detoledovictor/eSYS24-master/hardware/Transceiver/README.MD

# Overview
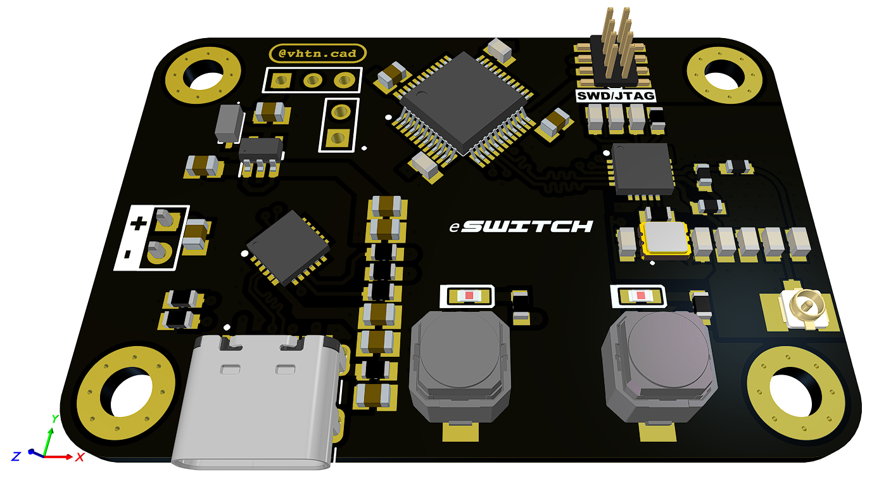
[picture p3: Images/eswitch_3D.PNG]
PCB 3D View


eSWITCH24 hardware designed with a four layers FR4 PCB material. I need four layer to implement the RF Stackup and better power plains that gives me flexibility to control power consumption in various scenarios.

I placed RF paths on the top layer with impedance control for Sub-GHz and 2.4 GHz frequencies.

As a handle IoT Switch, it needs to be literally wireless. So for this I design all the system to be powered up by an **ER14505 or ER25600 (AA) Lithium battery.**

For simplify the manufacture, I selected 0603 passive componnents, it's more easy to hand soldering.
To communicate PC USB with the MCU, I used the brigde [CP2102](https://www.silabs.com/documents/public/data-sheets/cp2102n-datasheet.pdf) it's more powerful and trustworthy than the CH341SER (used in the Arduino's board).
To reduce the **power consumption**, used the Low DropOut linear regulator [AP2112](https://www.diodes.com/assets/Datasheets/AP2112.pdf), instead of use a simple Linear Regulator.

This PCB is originally designed with Altium Designer version 21. All the files that required to build the PCB are included in [PCB files](/hardware/Transceiver/PCB_Files).

## Layers
After routing wires for all components I placed polygons on each layer. In table below I show all the polygons and their purpose in our design.

| Layer | Polygons Description |Image  |
| --- | --- |---|
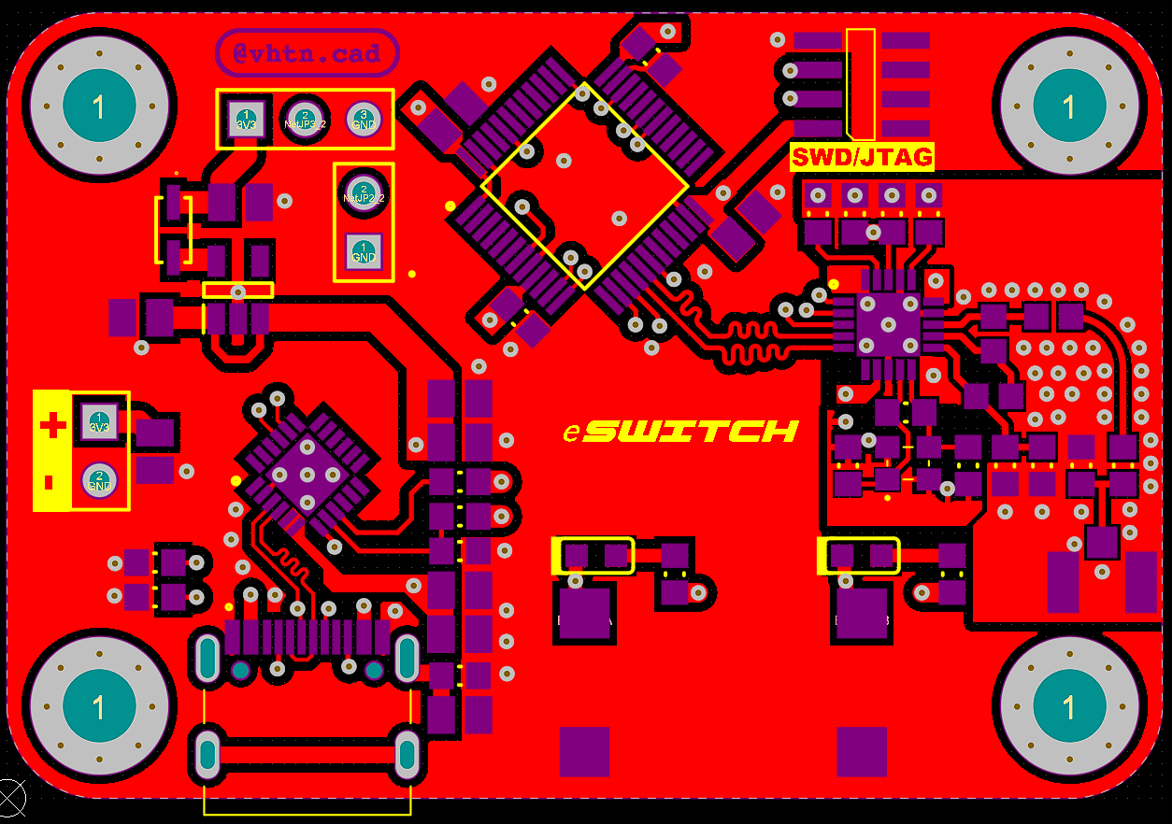
[picture p4: Images/eswitch_top.PNG]
Top Layer Polygon
| Top | Connected to GND.<br /> Multiple Polygons.<br /> Includes impedance control for RF paths.<br /> and all others connections. | |
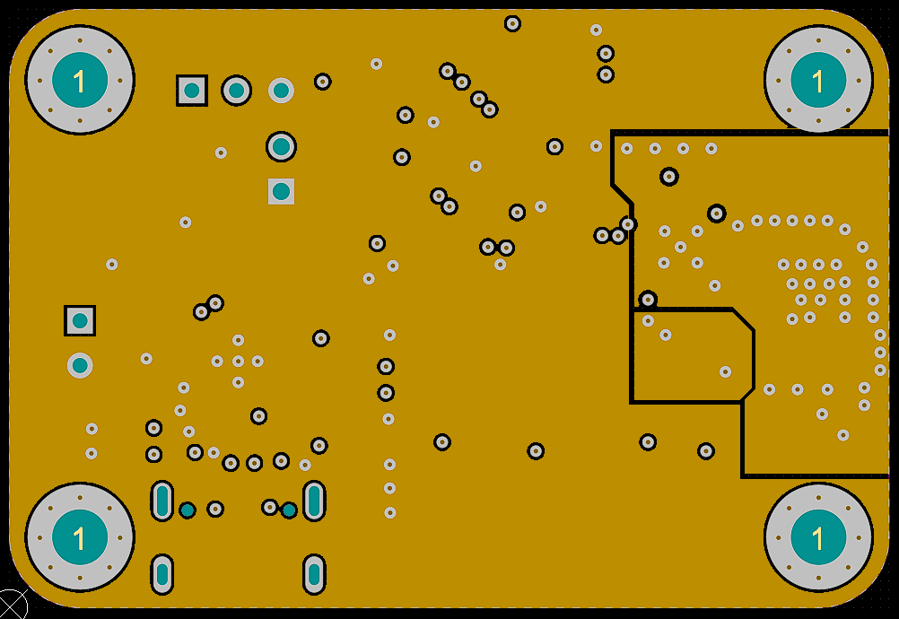
[picture p5: Images/eswitch_mid1.PNG]
Inner Layer 1 Polygon
| Inner 1 | Connected to GND. | |
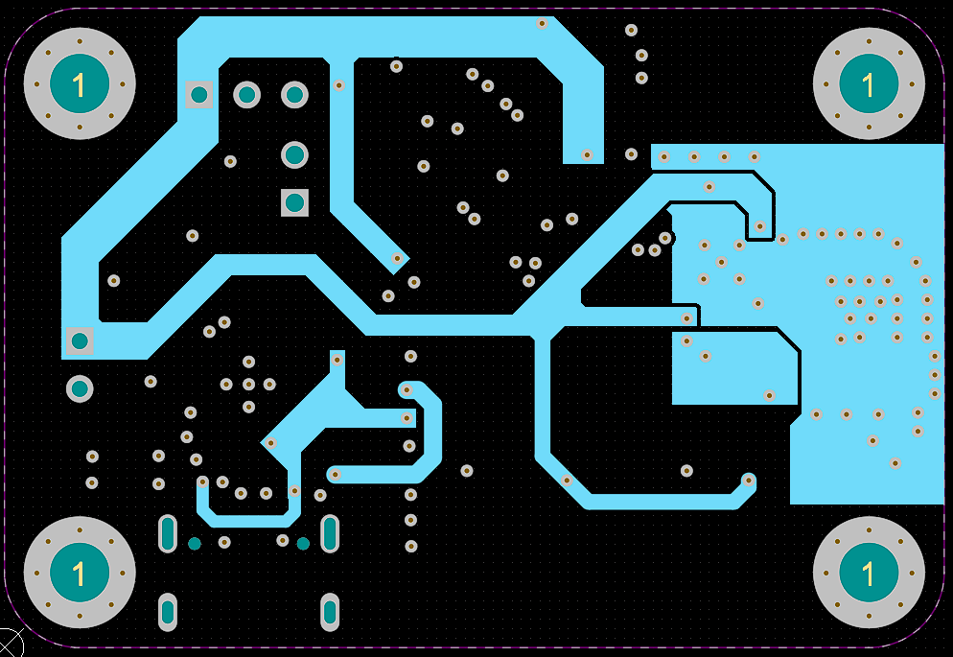
[picture p6: Images/eswitch_mid2.PNG]
Inner Layer 2 Polygon
| Inner 2 | Connected to POWER LINES. | |
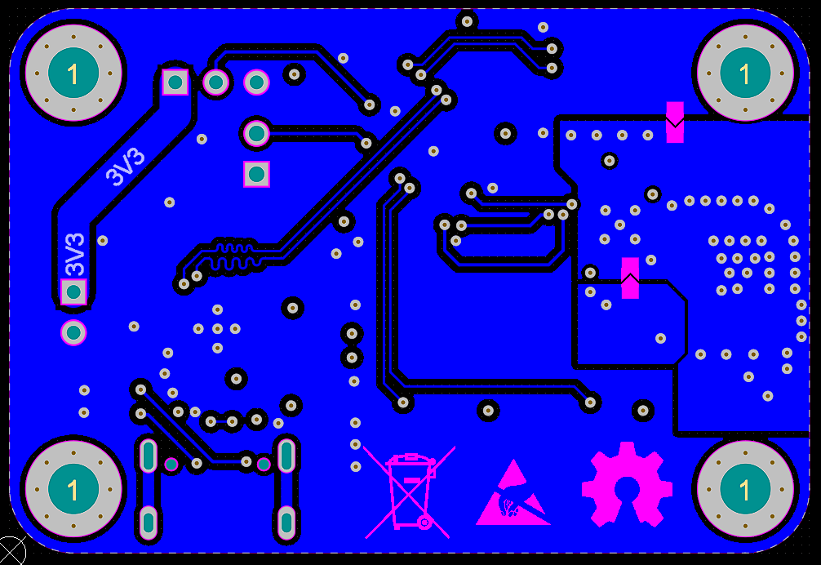
[picture p7: Images/eswitch_bottom.PNG]
Bottom Layer Polygon
| Bottom | Connected to GND.<br /> and to anothoer signal traces| |

## How to Use
To use PCB files in this directory follow these steps:
- Install the latest version of the [Altium Designer](https://www.altium.com/products/downloads)
- Download and extract [PCB files](/hardware/Transceiver/PCB_Files)
- Open project in Altium Designer
