detoledovictor/eSYS24-master/hardware/Receiver/README.MD

# Overview
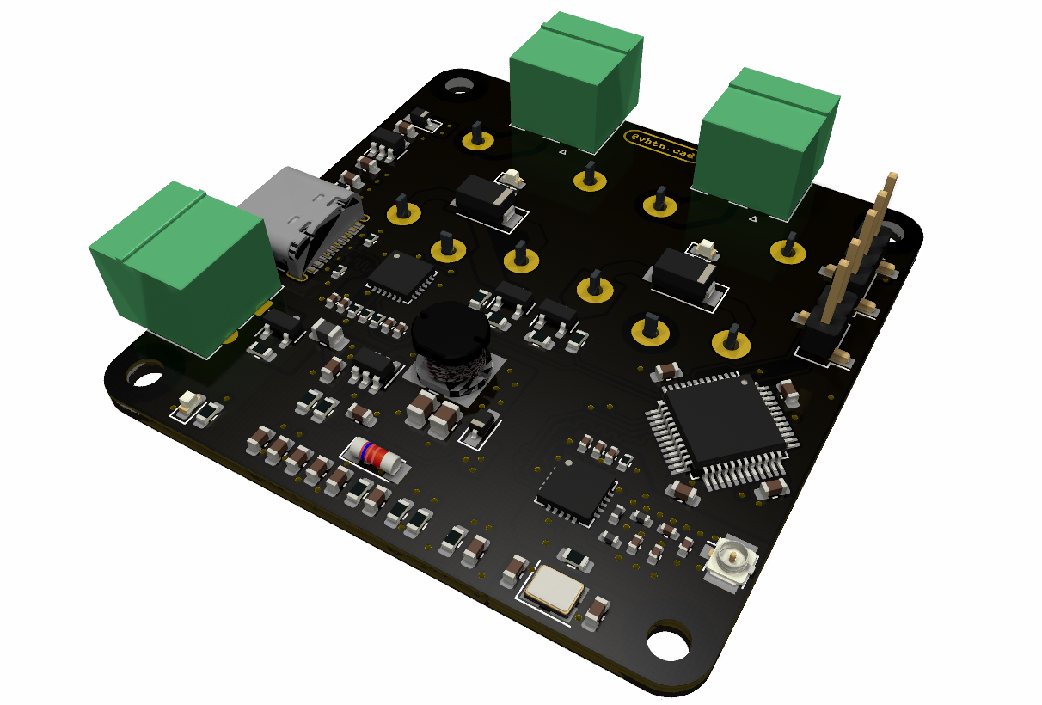
[picture p8: Images/econtrol_3Da.PNG]
PCB 3D View


eCONTROL24 hardware designed with a four layers FR4 PCB material. I need four layer to implement the RF Stackup and better power plains that gives me flexibility to control power consumption in various scenarios.

I placed RF paths on the top layer with impedance control for Sub-GHz and 2.4 GHz frequencies.

For simplify the manufacture, I selected for the great part of passive componnents 0603 package, it's more easy to hand soldering. Otherwise, I had to use 0402 passive componnets to the RF path and for the USB Bridge filter (**ONLY FOR OPTIMIZE SPACE**).<br />

To communicate PC USB with the MCU, I used the brigde [CP2102](https://www.silabs.com/documents/public/data-sheets/cp2102n-datasheet.pdf) it's more powerful and trustworthy than the CH341SER (used in the Arduino's board).<br />

Here we've a DC/DC converter, for this I used the [TPS564201](https://www.ti.com/lit/ds/symlink/tps564201.pdf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)  Synchronous Step-Down Voltage Regulator <br />

As we need an external power supply, the polarity protection is necessary, so the [FDN340P](https://www.onsemi.com/pdf/datasheet/fdn340p-d.pdf) will help us in this part.

To show the data received via RF, an [oLED 0.96inch](https://www.vishay.com/docs/37902/oled128o064dbpp3n00000.pdf) will be soldered in the bottom, how it uses the I2C communication, only 2 pins of the MCU are used to show the data, and why not debug too?!

This PCB is originally designed with KiCAD version 6. All the files that required to build the PCB are included in [PCB files](/hardware/Receiver/PCB_Files).

## Layers
After routing wires for all components I placed polygons on each layer. In table below I show all the polygons and their purpose in our design.

| Layer | Polygons Description |Image  |
| --- | --- |---|
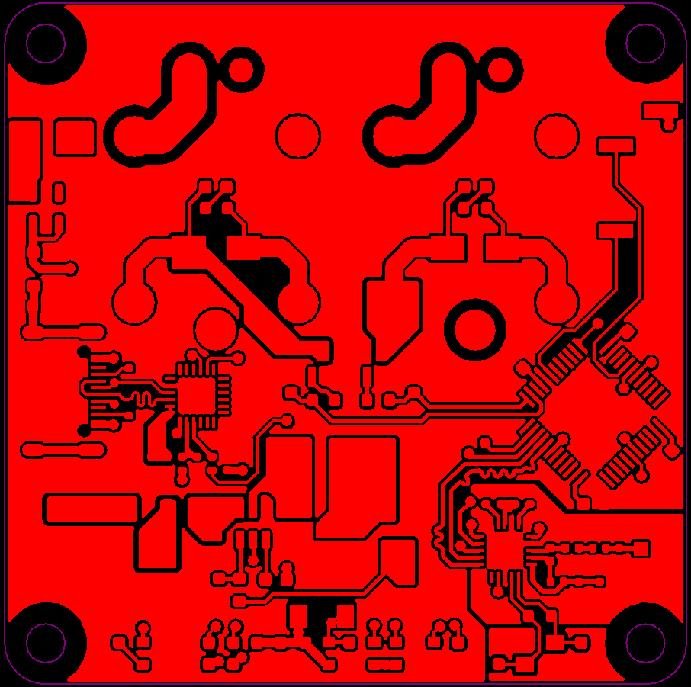
[picture p9: Images/econtrol_top.PNG]
Top Layer Polygon
| Top | Connected to GND.<br /> Multiple Polygons.<br /> Includes impedance control for RF paths.<br />and all others connections. | |
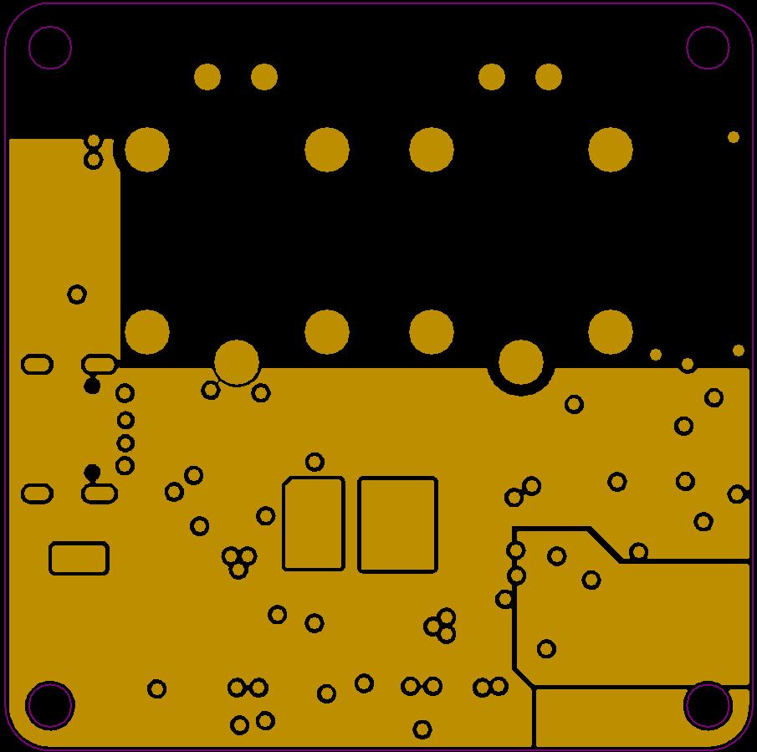
[picture p10: Images/econtrol_mid1.PNG]
Inner Layer 1 Polygon
| Inner 1 | Connected to GND. | |
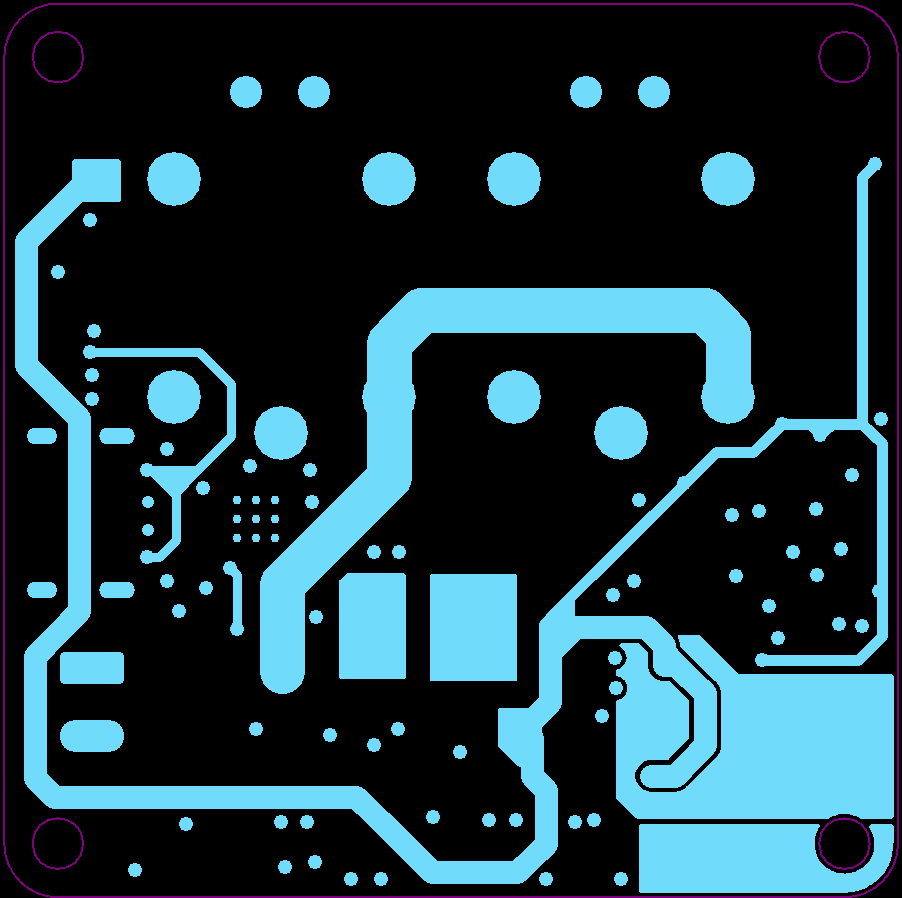
[picture p11: Images/econtrol_mid2.PNG]
Inner Layer 2 Polygon
| Inner 2 | Connected to POWER LINES. | |
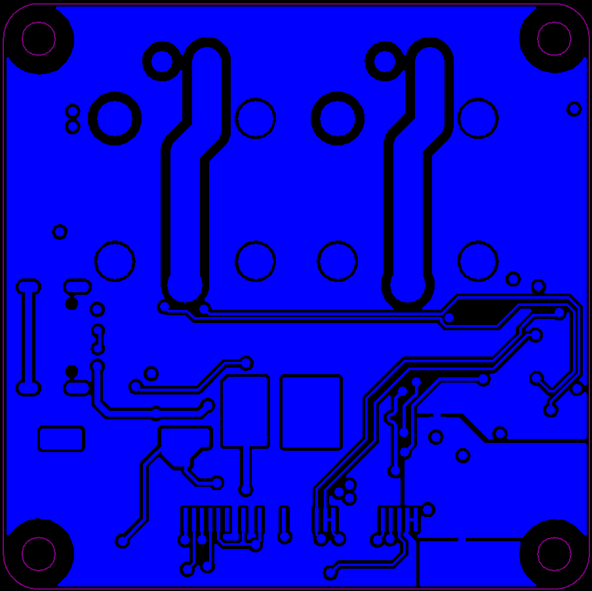
[picture p12: Images/econtrol_bottom.PNG]
Bottom Layer Polygon
| Bottom | Connected to GND.<br />and to anothoer signal traces. | |

## How to Use
To use PCB files in this directory follow these steps:
- Install the latest version of the [KiCAD](https://www.kicad.org/download/)
- Download and extract [PCB files](/hardware/Receiver/PCB_Files)
- Open project in KiCAD
