detoledovictor/eSYS24-master/hardware/Transceiver/PCB_Files/README.MD

## How to Use Altium Sources
To use PCB files in this directory follow these steps:
- Install the latest version of the [Altium Designer](https://www.altium.com/products/downloads)
- Download and extract the [files](./eSWITCH24.zip)
- Open project in Altium Designer
