detoledovictor/eSYS24-master/hardware/Receiver/PCB_Files/README.MD

## How to Use KiCAD Sources
To use PCB files in this directory follow these steps:
- Install the latest version of the [KiCAD](https://www.kicad.org/download/)
- Download and extract the [files](./eCONTROL24.zip)
- Open project in KiCAD
