detoledovictor/eSYS24-master/Images/econtrol3Db.PNG

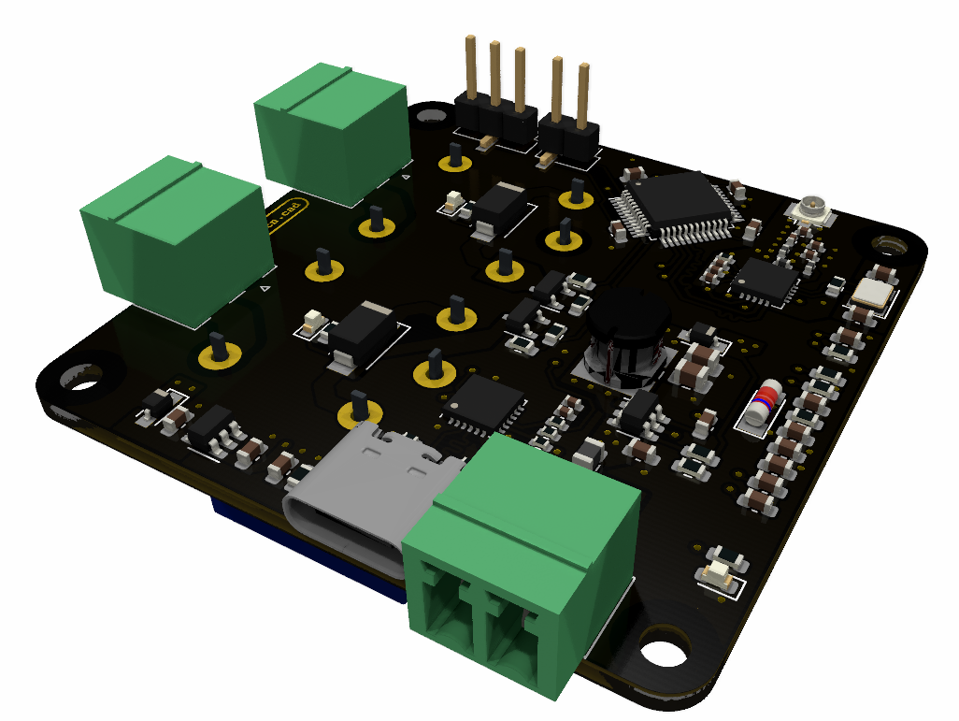
Images/econtrol3Db.PNG
