detoledovictor/eSYS24-master/Images/econtrol_3D.PNG

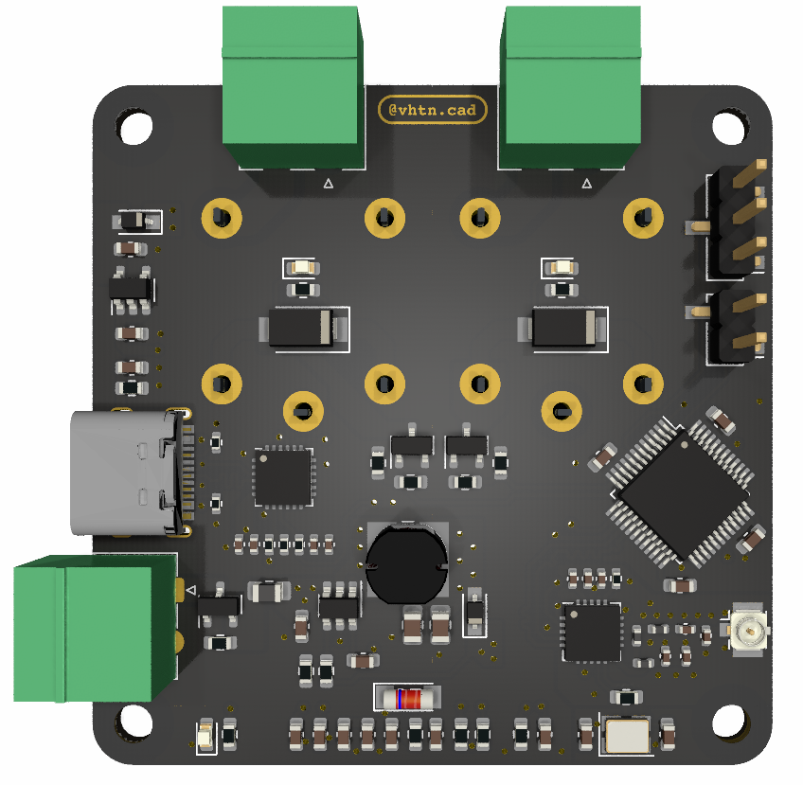
Images/econtrol_3D.PNG
