detoledovictor/eSYS24-master/Images/econtrol_3Dc.PNG

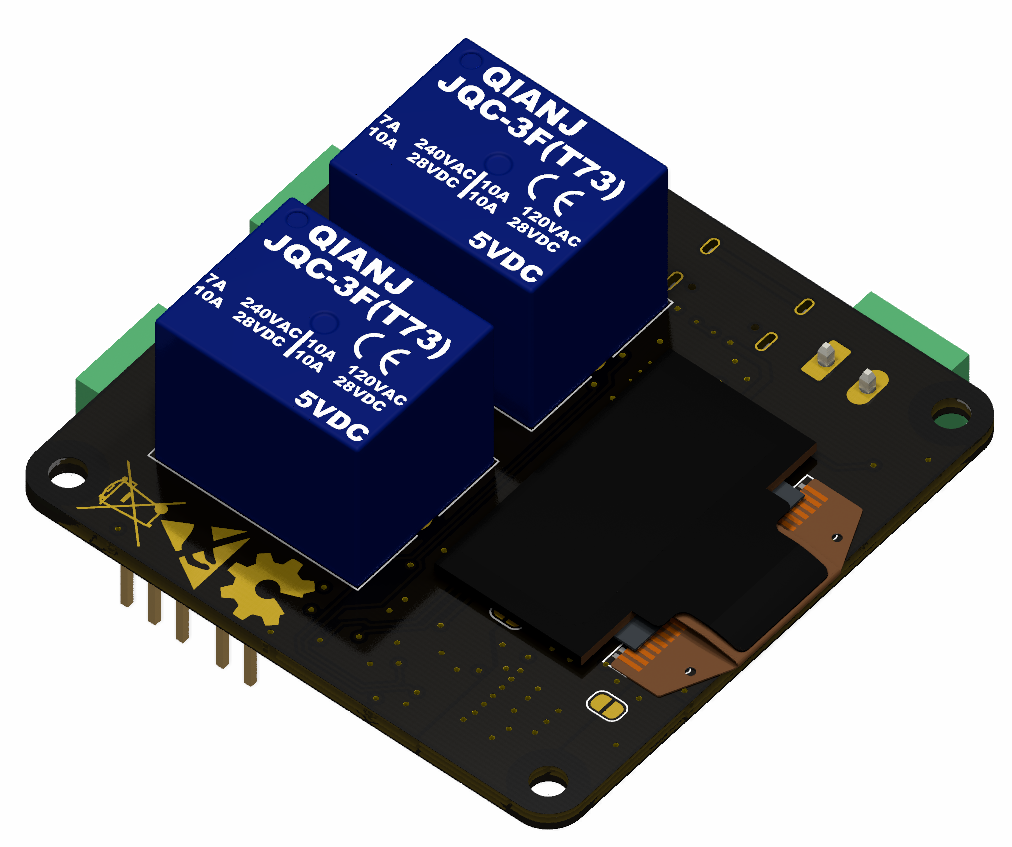
Images/econtrol_3Dc.PNG
