detoledovictor/eSYS24-master/Images/eswitch_3Da.PNG

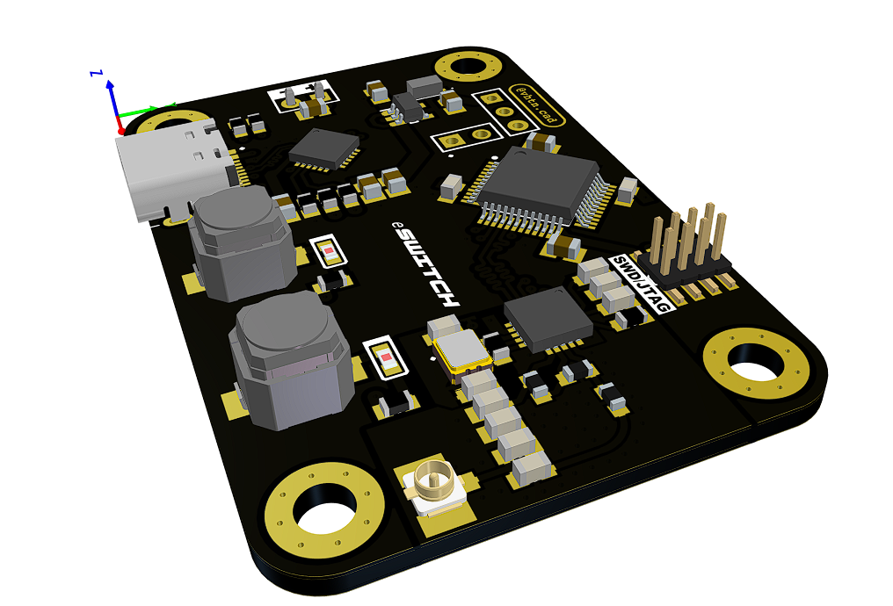
Images/eswitch_3Da.PNG
