detoledovictor/eSYS24-master/Images/eswitch_3Db.PNG

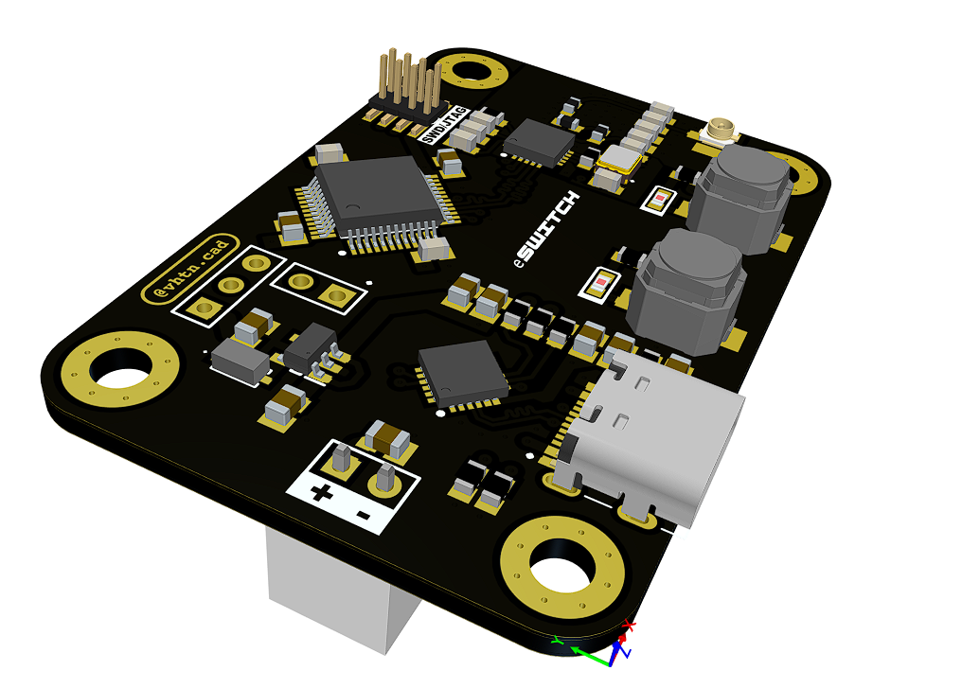
Images/eswitch_3Db.PNG
