detoledovictor/eSYS24-master/Images/eswitch_3Dc.PNG

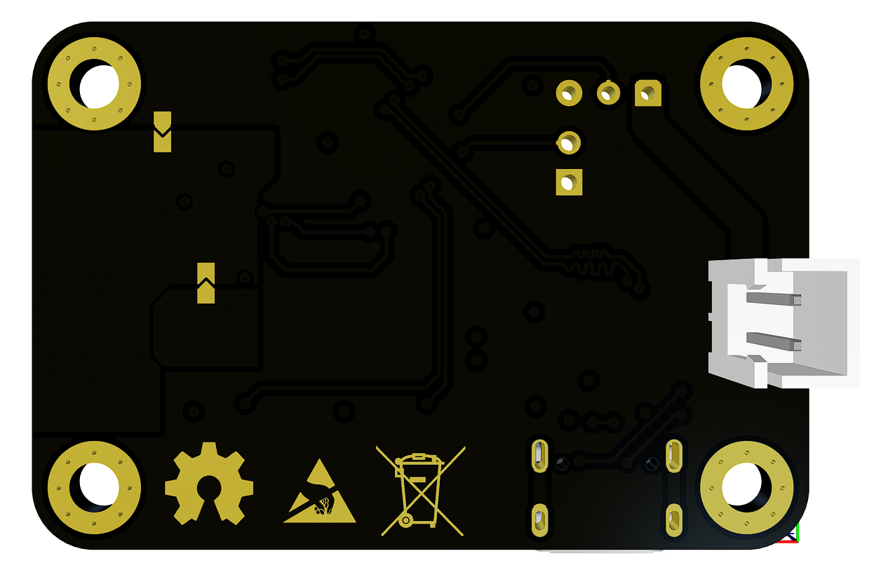
Images/eswitch_3Dc.PNG
