detoledovictor/eSYS24-master/hardware/Receiver/PCB_Files/BOM_eCONTROL24-r00.xls

BOM eCONTROL24 |  |  |  |  |  | R0
Item | Qtd | Referência | Part Number | Descrição | Encapsulamento | 2022-03-23
 |  |  |  |  |  | Fabricante
Inserção SMD
1 | 1 | U1 | STM32F103C8T6TR | ARM Microcontrollers - MCU 32BIT Cortex M3 USB 7 TIMERS 2 ADCS CAN FS 2.0, CAN, 9 timers, ADC and comm. interfaces, 2.0 - 3.6 V | LQFP - 48 | STMicroelectronics
2 | 1 | U2 | NRF24L01 | RF Transceiver 1.9-3.6V 2.4GHz XCVR ENHNCD SHCKBRST | QFN-20 | Nordic Semiconductor
3 | 1 | U3 | CP2102N | USB Interface IC USBXpress - USB to UART Bridge QFN24 | QFN-24 | Silicon Labs
4 | 1 | U4 | TPS564201 | Switching Voltage Regulators 4.5V to 17V Input 4A Output Sync | SOT-23-6 | Texas Instruments
5 | 1 | U5 | AP2112K-3.3TRG1 | LDO Voltage Regulators 600mA CMOS LDO 50mA 3.3V 250mV | SOT-25-5 | Diodes Incorporated
6 | 1 | Y1 | TSX-3225 16MHz | Crystals 16MHz 10ppm 16pF -10C +60C | 3.2 mm x 2.5 mm | aceita qualquer um, sugerir similares
7 | 2 | D3, D8 | BAT60JFILM | Schottky Diodes & Rectifiers 3.0 Amp 10 Volt | SOD-323 | STMicroelectronics
8 | 2 | D1, D2 | LL4007 | Rectifiers 1A 1000V Standard Re covery Rectifier | MELF | aceita qualquer um, sugerir similares
9 | 1 | D7 | LL4148 | General Purpose, Power, Switching Small Signal Diode, SOD-80, 100V, 0.15A, 4n | MINI MELF | aceita qualquer um, sugerir similares
10 | 6 | C15, C18, C19, C22, C29, C30 | CL10B104KB8NNNL | 100nF | Capacitor 0603 | aceita qualquer um, sugerir similares
11 | 7 | C4, C5, C6, C12, C14, C31, C32 | CL10A105KP8NNND | 1uF | Capacitor 0603 | aceita qualquer um, sugerir similares
12 | 7 | C3 | CL10A106KP8NNND | 10uF | Capacitor 0603 | aceita qualquer um, sugerir similares
13 | 2 | C24, C27 | CL10A475KP8NNND | 4.7uF | Capacitor 0603 | aceita qualquer um, sugerir similares
14 | 2 | C20, C21 | CL21A226KQQNNNE | 22uF | Capacitor 0805 | aceita qualquer um, sugerir similares
15 | 2 | C23, C26 | CL05A475MQ5NRNC | 4.7uF | Capacitor 0402 | aceita qualquer um, sugerir similares
16 | 2 | C25, C28 | CL05B102KO5NNWC | 100nF | Capacitor 0402 | aceita qualquer um, sugerir similares
17 | 1 | C16 | CL05B103KB5NNNC | 10nF | Capacitor 0402 | aceita qualquer um, sugerir similares
18 | 1 | C17 | CL05B102KO5NNWC | 1nF | Capacitor 0402 | aceita qualquer um, sugerir similares
19 | 1 | C7 | CL05B222KB5VPNC | 2.2nF | Capacitor 0402 | aceita qualquer um, sugerir similares
20 | 1 | C2 | CL05B333KP5NNWC | 33nF | Capacitor 0402 | aceita qualquer um, sugerir similares
21 | 1 | C13 | CL05C010CB5NNNC | 1pF | Capacitor 0402 | aceita qualquer um, sugerir similares
22 | 1 | C11 | CL05C1R5BB5NNNC | 1.5pF | Capacitor 0402 | aceita qualquer um, sugerir similares
23 | 1 | C9 | CL05C4R7CB51PNC | 4.7pF | Capacitor 0402 | aceita qualquer um, sugerir similares
24 | 2 | C8, C10 | CL10C220JB81PNC | 22pF | Capacitor 0603 | aceita qualquer um, sugerir similares
25 | 1 | L4 | MCLA1005V2-3R9-R | 3.9nH | Inductor 0603 | aceita qualquer um, sugerir similares
26 | 1 | L3 | LQG15HN8N2J02D | 8.2nH | Inductor 0603 | aceita qualquer um, sugerir similares
27 | 1 | L5 | LQW15AN2N7C00D | 2.7nH | Inductor 0603 | aceita qualquer um, sugerir similares
28 | 1 | L1 | 1264EY-3R3NP3 | 3.3uH | Inductor CD54 | aceita qualquer um, sugerir similares
29 | 2 | R10, R17 | RC0603JR-072K2L | RESISTOR FILME 2K2 5% 1/10W | RESISTOR 0603 | aceita qualquer um, sugerir similares
30 | 2 | R7, R18 | RC0603JR-071ML | RESISTOR FILME 1M 5% 1/10W | RESISTOR 0603 | aceita qualquer um, sugerir similares
31 | 1 | R5 | RC0603JR-074K7L | RESISTOR FILME 4K7 5% 1/10W | RESISTOR 0603 | aceita qualquer um, sugerir similares
32 | 8 | R3, R4, R8, R9, R11, R14, R15, R16 | RC0603JR-0710KL | RESISTOR FILME 10K 5% 1/10W | RESISTOR 0603 | aceita qualquer um, sugerir similares
33 | 1 | R6 | RC0603JR-07390KL | RESISTOR FILME 390K 5% 1/10W | RESISTOR 0603 | aceita qualquer um, sugerir similares
34 | 1 | R13 | RC0603JR-07330KL | RESISTOR FILME 330K 5% 1/10W | RESISTOR 0603 | aceita qualquer um, sugerir similares
35 | 1 | R12 | RC0603JR-07100KL | RESISTOR FILME 100K 5% 1/10W | RESISTOR 0603 | aceita qualquer um, sugerir similares
36 | 1 | R23 | RC0402JR-071KL | RESISTOR FILME 1K 5% 1/16W | RESISTOR 0402 | aceita qualquer um, sugerir similares
37 | 3 | R19, R20, R21 | RC0402JR-074K7L | RESISTOR FILME 4K7 5% 1/16W | RESISTOR 0402 | aceita qualquer um, sugerir similares
38 | 1 | R22 | RC0402JR-0722KL | RESISTOR FILME 22K 5% 1/16W | RESISTOR 0402 | aceita qualquer um, sugerir similares
39 | 1 | R2 | RC0402JR-0710KL | RESISTOR FILME 10K 5% 1/16W | RESISTOR 0402 | aceita qualquer um, sugerir similares
40 | 2 | D4, D5 | 150060RS75000 | LED SMD 0603 RED | LED 0603 | Kingbright (aceita similar)
41 | 1 | D6 | 150060VS75000 | LED SMD 0603 GREEN | LED 0603 | Kingbright (aceita similar)
42 | 1 | Q1 | FDN340P | MOSFET SSOT-3 P-CH -20V | SOT-23 | aceita qualquer um, sugerir similares
43 | 2 | Q2, Q3 | BC817 | Bipolar Transistors - BJT SOT23,NPN,0.8A,45V,G | SOT-23 | aceita qualquer um, sugerir similares
44 | 1 | FB1 | 742792011 | Ferrite 10ohm/3A (0805) | Inductor 0805 | aceita qualquer um, sugerir similares
45 | 1 | DS1 | OLED-128O064D | Oled Display 0.96inch | SMD 30pins | aceita qualquer um, sugerir similares
46 | 1 | USB-C | USB4105-GF-A | USB Connectors USB Type C | USB Type C | aceita qualquer um, sugerir similares
47 | 1 | IPEX U.FL | C40BA3C20279-001E-01 / IPEX 20279 RECEPTACLE (UFL) | CONN UMC RCPT STR 50 OHM SMD | U.FL (UMCC), IPEX MHF1
Inserção PTH
48 | 2 | K1, K2 | SRD-S-112D | RELAY 12VDC COIL |  | aceita qualquer um, sugerir similares
49 | 3 | J2, J5, J6 | 15EDGRC-3.5-02P | Pluggable Terminal Blocks 2 Pos 3.81mm pitch Through Hole Header | Passo 3.81mm | Phoenix, aceita similares
Acabamento
50 | 1 | - | PCI-eCONTROL24-V00 | PCI | - | JLCPCB
51 | 1 | - | 15EDGK-3.5-02P | Alojamento Macho | Passo 3.81mm | aceita qualquer um, sugerir similares
52
