detoledovictor/eSYS24-master/hardware/Transceiver/PCB_Files/BOM_eSWITCH24-r00.xls

BOM eSWITCH24 |  |  |  |  |  | R0
Item | Qtd | Referência | Part Number | Descrição | Encapsulamento | 2022-03-23
 |  |  |  |  |  | Fabricante
Inserção SMD
1 | 1 | U1 | STM32F103C8T6TR | ARM Microcontrollers - MCU 32BIT Cortex M3 USB 7 TIMERS 2 ADCS CAN FS 2.0, CAN, 9 timers, ADC and comm. interfaces, 2.0 - 3.6 V | LQFP - 48 | STMicroelectronics
2 | 1 | U2 | NRF24L01 | RF Transceiver 1.9-3.6V 2.4GHz XCVR ENHNCD SHCKBRST | QFN-20 | Nordic Semiconductor
3 | 1 | U3 | CP2102N | USB Interface IC USBXpress - USB to UART Bridge QFN24 | QFN-24 | Silicon Labs
4 | 1 | U4 | AP2112K-3.3TRG1 | LDO Voltage Regulators 600mA CMOS LDO 50mA 3.3V 250mV | SOT-25-5 | Diodes Incorporated
5 | 1 | X1 | TSX-3225 16MHz | Crystals 16MHz 10ppm 16pF -10C +60C | 3.2 mm x 2.5 mm | aceita qualquer um, sugerir similares
6 | 1 | D1 | BAT60JFILM | Schottky Diodes & Rectifiers 3.0 Amp 10 Volt | SOD-323 | STMicroelectronics
7 | 5 | C13, C15, C19, C20, C21 | CL10B104KB8NNNL | 100nF | Capacitor 0603 | aceita qualquer um, sugerir similares
8 | 4 | C11, C12, C17, C18 | CL10A105KP8NNND | 1uF | Capacitor 0603 | aceita qualquer um, sugerir similares
9 | 1 | C10 | CL21A106KQFNNWE | 10uF | Capacitor 0805 | aceita qualquer um, sugerir similares
10 | 2 | C14, C16 | CL21A475KBQNNNE (https://www.mouser.com/ProductDetail/Samsung-Electro-Mechanics/CL21A475KBQNNNE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) | 4.7uF | Capacitor 0805 | aceita qualquer um, sugerir similares
11 | 1 | C3 | CL10B103KB8NFNC | 10nF | Capacitor 0603 | aceita qualquer um, sugerir similares
12 | 1 | C4 | CL10B102KB8WPNL | 1nF | Capacitor 0603 | aceita qualquer um, sugerir similares
13 | 1 | C9 | CL10B222JB8NNWC | 2.2nF | Capacitor 0603 | aceita qualquer um, sugerir similares
14 | 1 | C5 | CL10B333KB8NNND | 33nF | Capacitor 0603 | aceita qualquer um, sugerir similares
15 | 1 | C6 | 06031A1R0BAT4A | 1pF | Capacitor 0603 | aceita qualquer um, sugerir similares
16 | 1 | C7 | C0603C159C4HACTU | 1.5pF | Capacitor 0603 | aceita qualquer um, sugerir similares
17 | 1 | C8 | CL10C4R7BB8NNNC | 4.7pF | Capacitor 0603 | aceita qualquer um, sugerir similares
18 | 2 | C1, C2 | CL10C220JB81PNC | 22pF | Capacitor 0603 | aceita qualquer um, sugerir similares
19 | 1 | L1 | LQW18AN3N9D00D | 3.9nH | Inductor 0603 | aceita qualquer um, sugerir similares
20 | 1 | L2 | LQW18AS8N2J0CD | 8.2nH | Inductor 0603 | aceita qualquer um, sugerir similares
21 | 1 | L3 | LQW18AN8N7D00D | 2.7nH | Inductor 0603 | aceita qualquer um, sugerir similares
22 | 2 | R1, R9 | RC0603JR-0722KL | RESISTOR FILME 22K 5% 1/10W | RESISTOR 0603 | aceita qualquer um, sugerir similares
23 | 2 | R2, R10 | RC0603JR-071ML | RESISTOR FILME 1M 5% 1/10W | RESISTOR 0603 | aceita qualquer um, sugerir similares
24 | 3 | R3, R4, R5 | RC0603JR-071KL | RESISTOR FILME 1K 5% 1/10W | RESISTOR 0603 | aceita qualquer um, sugerir similares
25 | 2 | R6, R7 | RC0603JR-074K7L | RESISTOR FILME 4K7 5% 1/10W | RESISTOR 0603 | aceita qualquer um, sugerir similares
26 | 1 | R8 | RC0603JR-0747KL | RESISTOR FILME 47K 5% 1/10W | RESISTOR 0603 | aceita qualquer um, sugerir similares
27 | 2 | LD1, LD2 | APTD1608LSURCK | LED SMD 0603 RED | LED 0603 | Kingbright (aceita similar)
28 | 1 | BTA, BTB | SKPMAME010 | Tactile Switches 50 mAmps at 12 Volts | TACTILE SWITCH | aceita qualquer um, sugerir similares
29 | 1 | USB-C | UX60SC-MB-5ST | USB Connectors MINI B RECEPT RA SMT BTTM MNT | MINI USB | aceita qualquer um, sugerir similares
30 | 1 | JTAG/SWD | FTR-102-02-S-D | Headers Surface Mount Micro Header, 0.050 x 0.100 Pitch | SMD PIN HEADER | aceita qualquer um, sugerir similares
31 | 1 | IPEX U.FL | C40BA3C20279-001E-01 / IPEX 20279 RECEPTACLE (UFL) | CONN UMC RCPT STR 50 OHM SMD | U.FL (UMCC), IPEX MHF1
Inserção PTH
20 | 1 | CN2 | JST XH2.54 2-PIN | Connector JST XH2.54mm 2 pin | Passo 2.54mm | aceita qualquer um, sugerir similares
Acabamento
24 | 1 | - | PCI-eSWITCH24-V00 | PCI | - | JLCPCB
25 | 1 | Plug JST + Alojamento | JST XH2.54 2-PIN | Alojamento Fêmea | Passo 2.54mm | aceita qualquer um, sugerir similares
26 | 32 | Bateria ER14505/ER26500 | ER14505 / ER26500 | Bateria 3,6V ER14505 AA Lithium |  | aceita qualquer um, sugerir similares
