detoledovictor/eSYS24-master/hardware/Receiver/eCONTROL24-SCHEMATIC.pdf

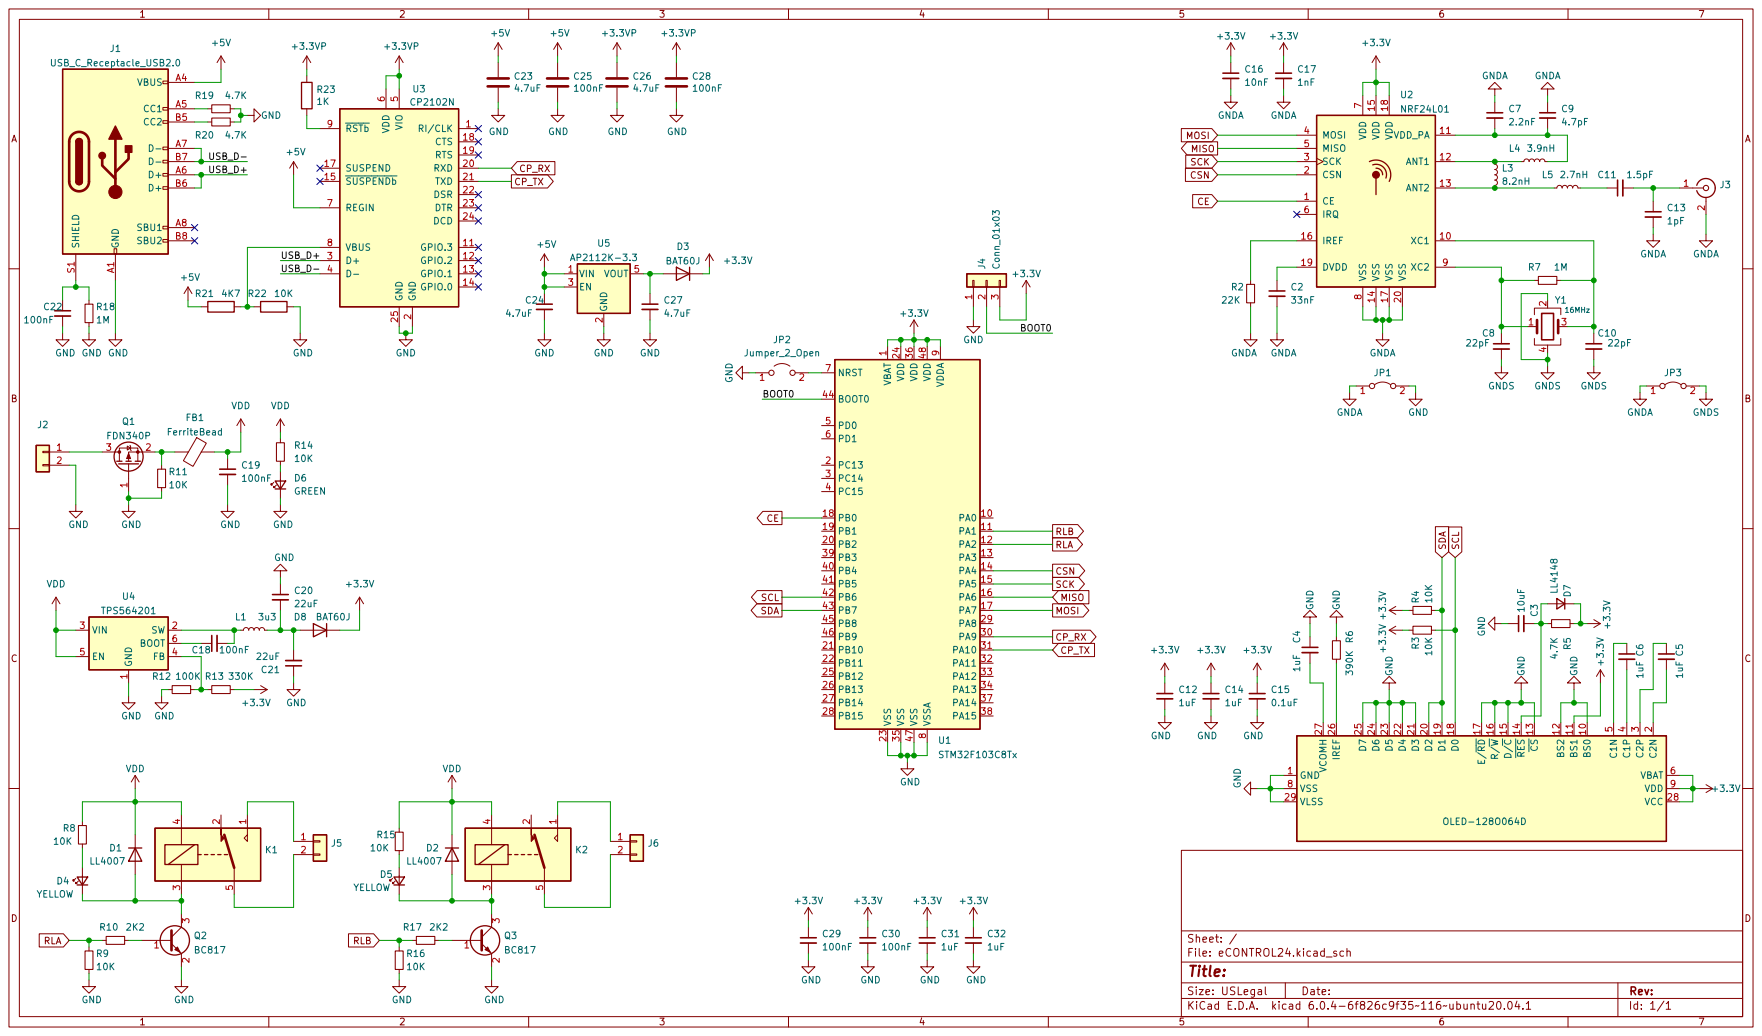
[picture p19: page 1]

6 REGIN 7 VBUS 8 ~{RSTb} 9 U3 CP2102N GND

2 RXD 20 TXD 21 DSR 22 DTR 23 DCD 24 GND 25 D+ 3 D- 4 VIO

1 PA0 10 PA1 11 PA2 12 PA3 13 PA4 14 PA5 15 PA6 16 PA7 17 PB0 18 PB1 19 PC13 2 PB2 20 PB10 21 PB11 22 VSS 23 VDD 24 PB12 25 PB13 26 PB14 27 PB15 28 PA8 29 PC14 3 PA9 30 PA10 31 PA11 32 PA12 33 PA13 34 VSS 35 VDD 36 PA14 37 PA15 38 PB3 39 PC15 4 PB4 40 PB5 41 PB6 42 PB7 43 BOOT0 44 PB8 45 PB9 46 VSS 47 VDD 48 PD0 5 PD1 6 NRST 7 VSSA

1 SW 2 VIN 3 FB 4 EN 5 BOOT 6 U4 TPS564201

5 VBAT 6 VSS 8 VDD 9 OLED-128O064D GND C310uF GND+3.3V GND+3.3V C5 GND 1uF

2 D2 20 D3 21 D4 22 D5 23 D6 24 D7 25 IREF 26 VCOMH 27 VCC 28 VLSS 29 C2P
