detoledovictor/eSYS24-master/hardware/Transceiver/eSWITCH24-SCHEMATIC.pdf

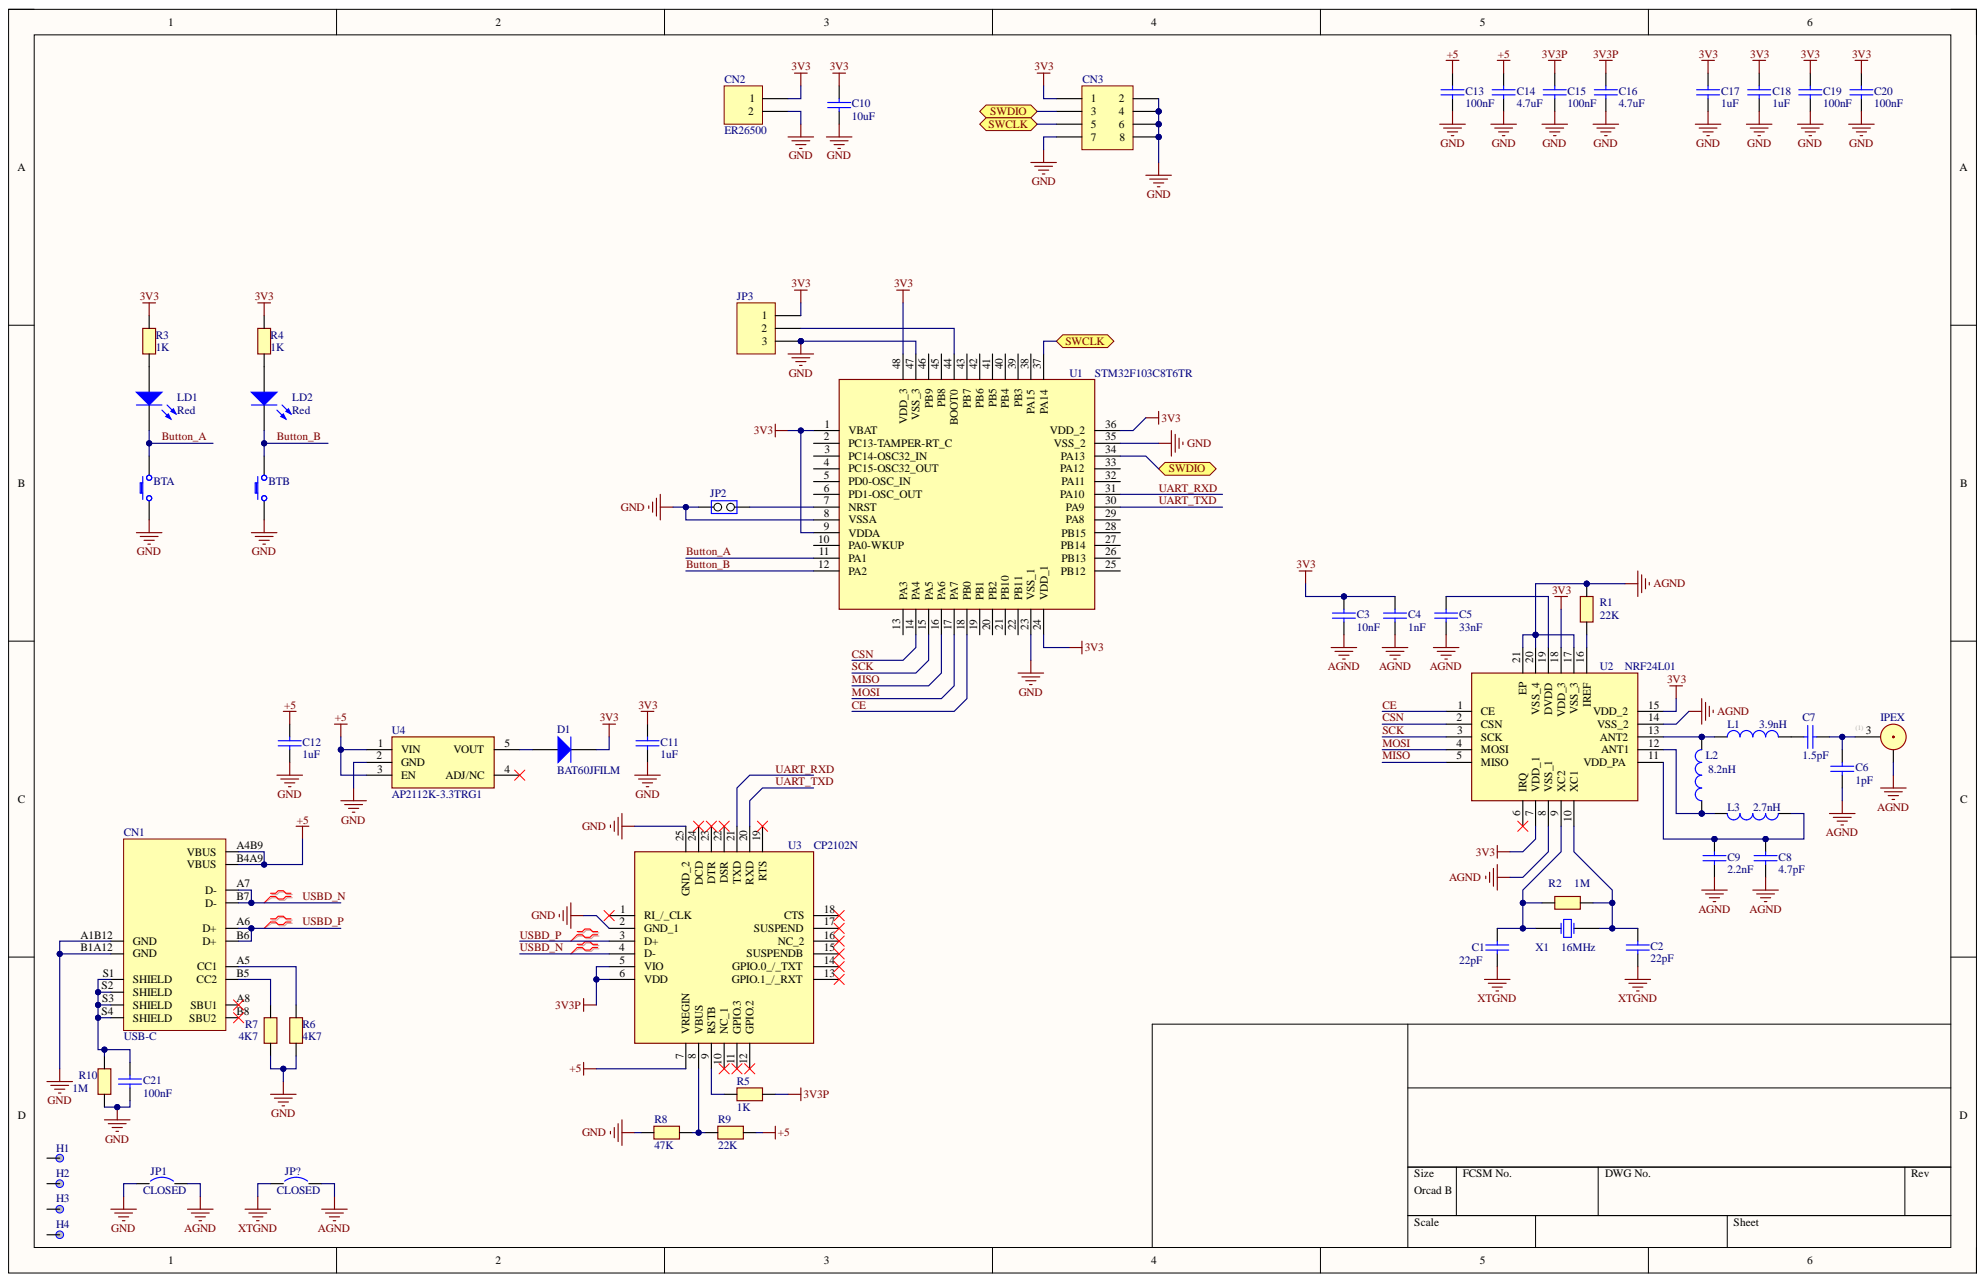
[picture p20: page 1]

VSSA 8
VDDA 9
